ethandgoodhart/autonomous-golf-cart/hardware/sensors/calibration/boards/charuco_US_LETTER_7x10_25mm_18mm_DICT5X5_1000_actual_size.pdf

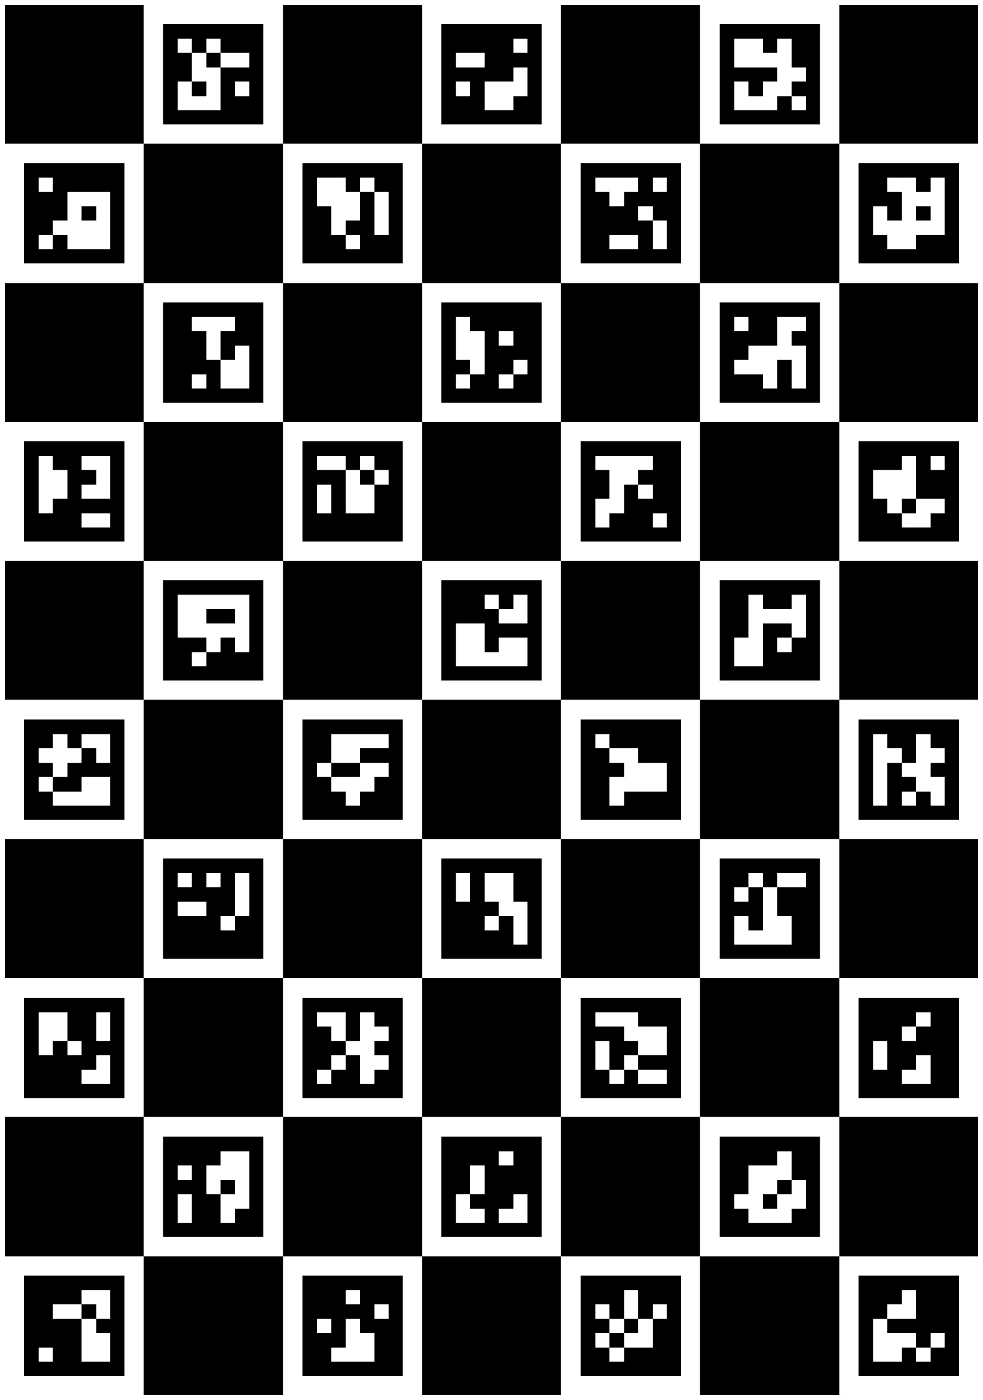
[picture p3: page 1]
