ethandgoodhart/autonomous-golf-cart/(commit log)

2026-09-24 Initial commit: autonomous golf cart monorepo
    Brings together cart-api (cartlib), drive-by-rtk, drive-by-segmentation,
    Arduino firmware, subsystem docs, and a hardware design folder.
2026-09-24 Reorganize repo: policies/, hardware/arduino-sketches
    - Rename driving-policies/ to policies/
    - Move firmware/ to hardware/arduino-sketches/ and add hardware/cad/
    - README: drop repository layout section
2026-09-24 README: remove Arduino badge
